designmaster0928/Calliope-Opens-Eyes/Photos/IMG_20220707_080942.jpg

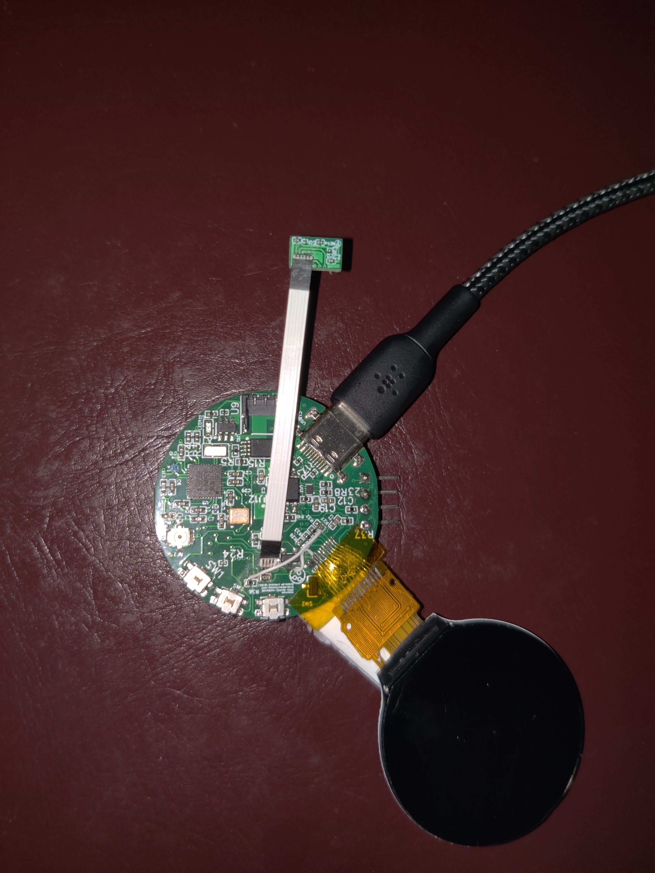
Photos/IMG_20220707_080942.jpg
