designmaster0928/Calliope-Opens-Eyes/Photos/IMG_20220710_211812.jpg

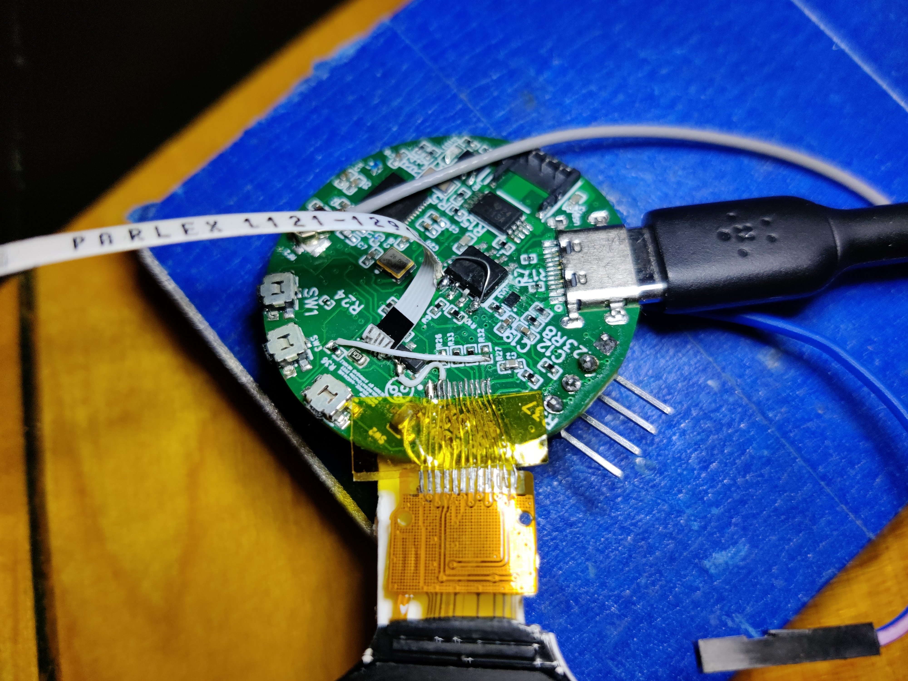
Photos/IMG_20220710_211812.jpg
