designmaster0928/Calliope-Opens-Eyes/Document/Belinda FPC adaptor 3f5895c3af74f1fa5b2311e33c003cb9.jpg

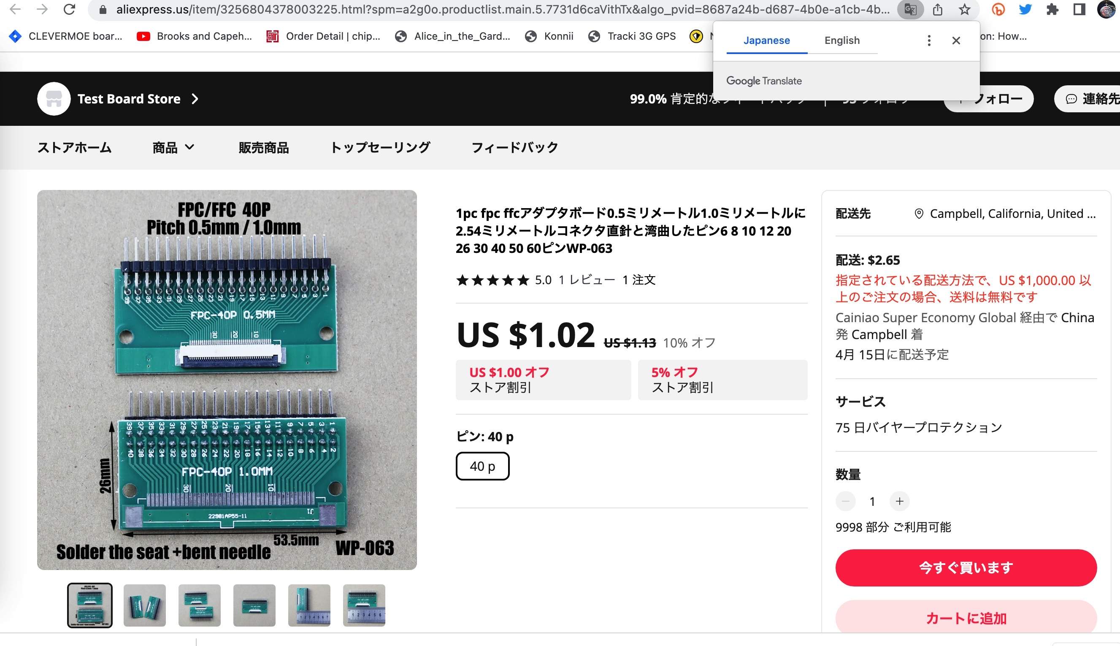
Document/Belinda FPC adaptor 3f5895c3af74f1fa5b2311e33c003cb9.jpg
