designmaster0928/Calliope-Opens-Eyes/Photos/CindyLou_daughter_board.jpg

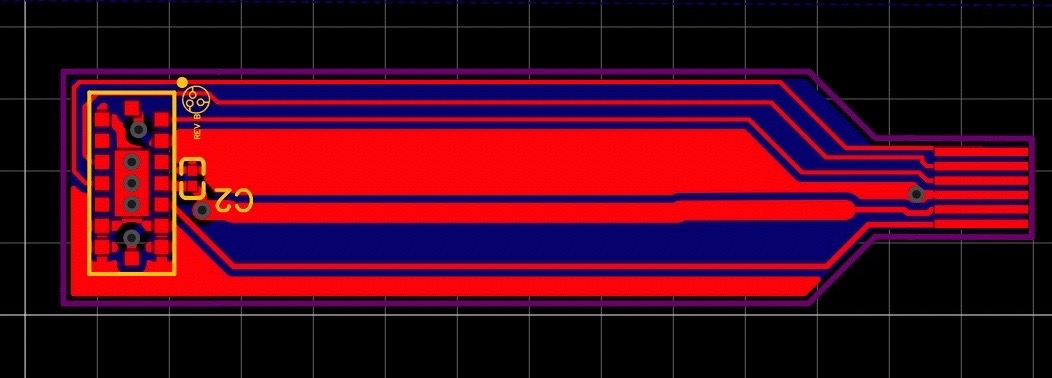
Photos/CindyLou_daughter_board.jpg
