designmaster0928/Calliope-Opens-Eyes/Photos/CindyLou_main_board.jpg

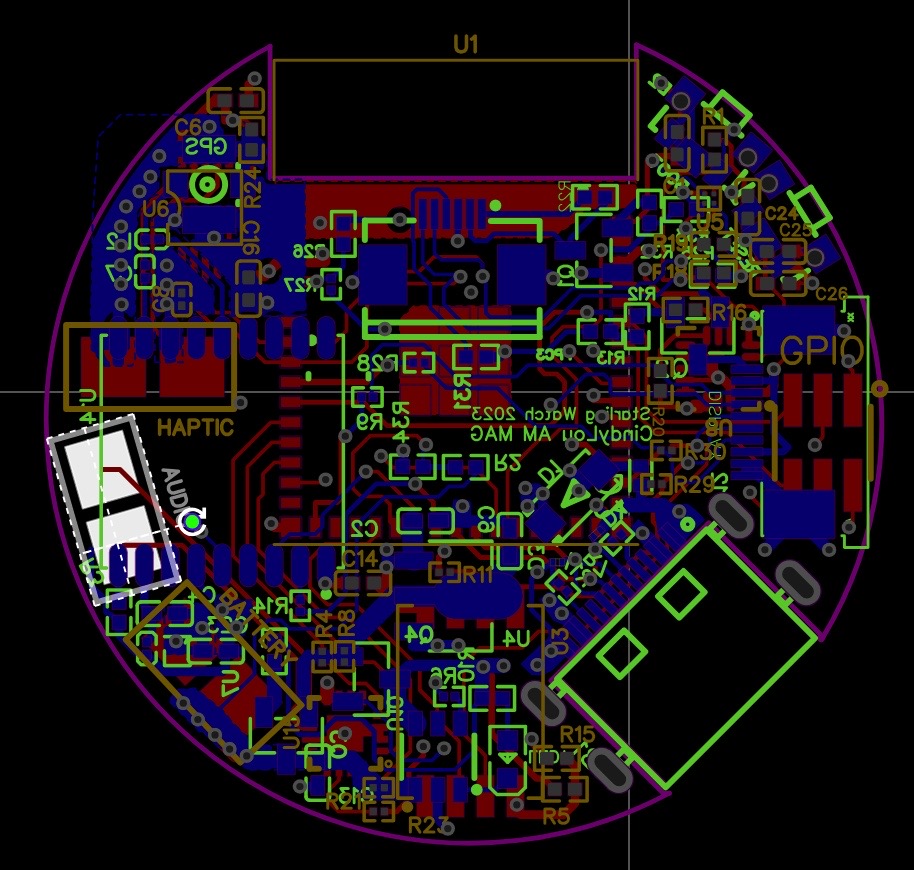
Photos/CindyLou_main_board.jpg
