designmaster0928/Calliope-Opens-Eyes/Photos/Hoober_with_reworks_back.jpg

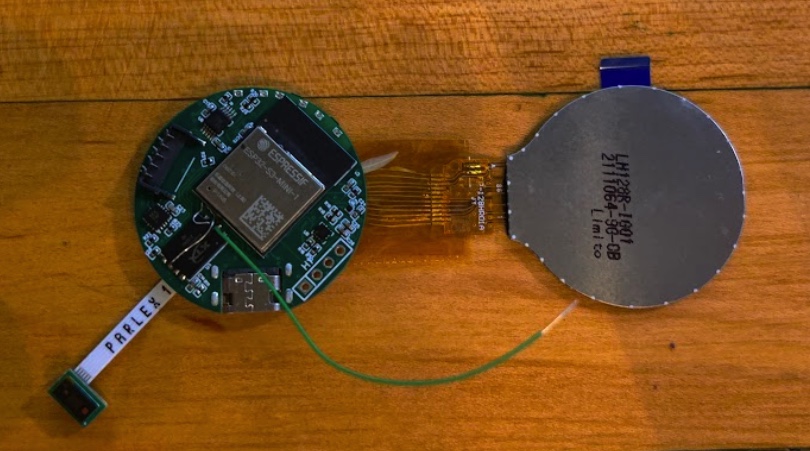
Photos/Hoober_with_reworks_back.jpg
