designmaster0928/Calliope-Opens-Eyes/Photos/Hoober_with_reworks_front.jpg

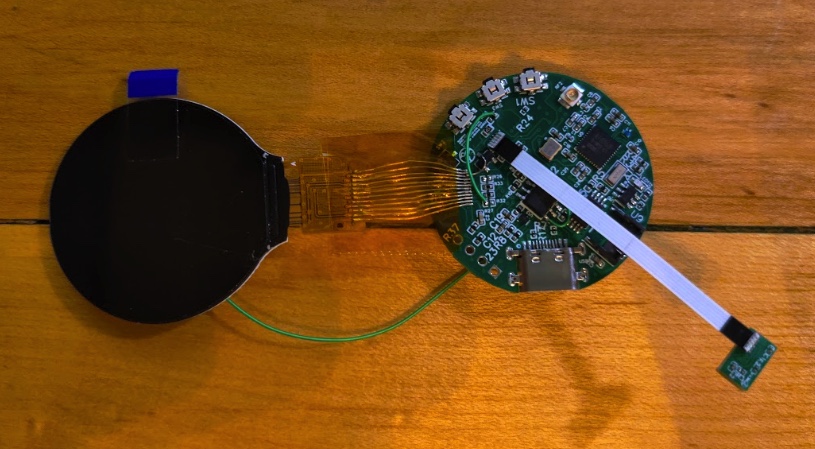
Photos/Hoober_with_reworks_front.jpg
