designmaster0928/Calliope-Opens-Eyes/Photos/IMG_20220601_134554.jpg

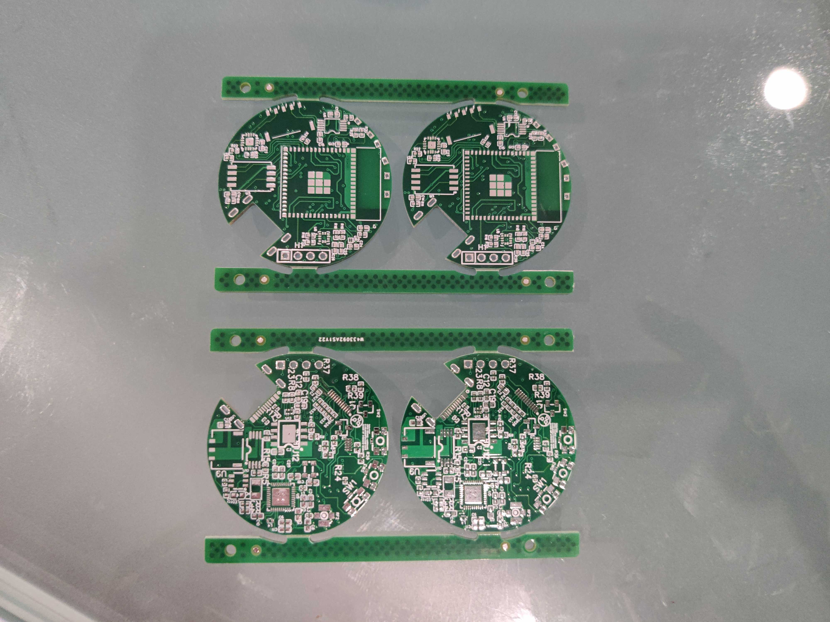
Photos/IMG_20220601_134554.jpg
