designmaster0928/Calliope-Opens-Eyes/Photos/IMG_20220627_172540.jpg

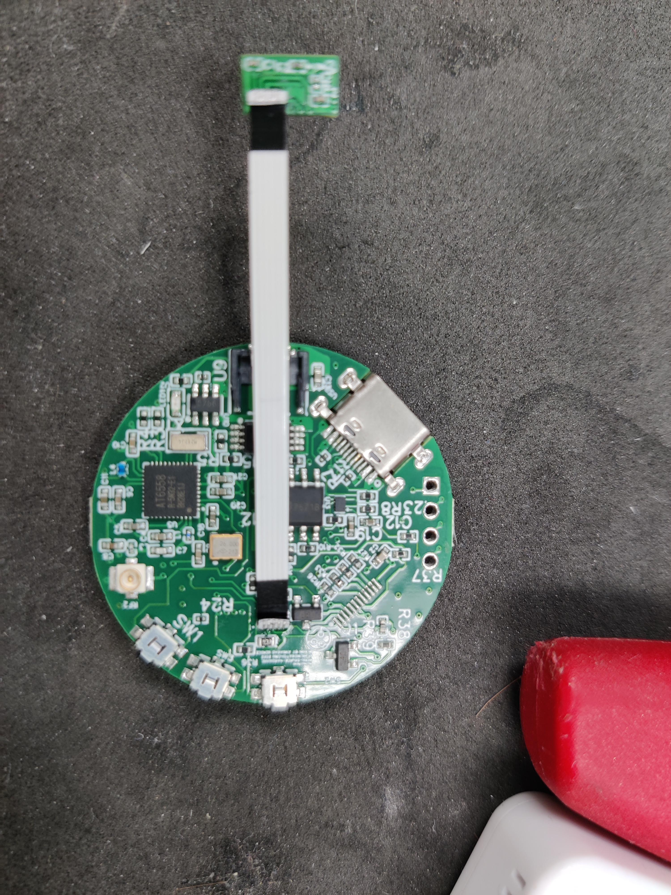
Photos/IMG_20220627_172540.jpg
