designmaster0928/Calliope-Opens-Eyes/Photos/IMG_20220627_172551.jpg

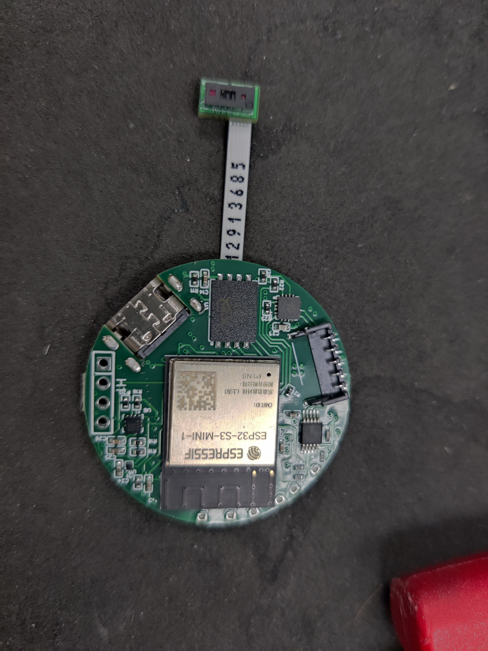
Photos/IMG_20220627_172551.jpg
