designmaster0928/Calliope-Opens-Eyes/Photos/IMG_20220627_183308.jpg

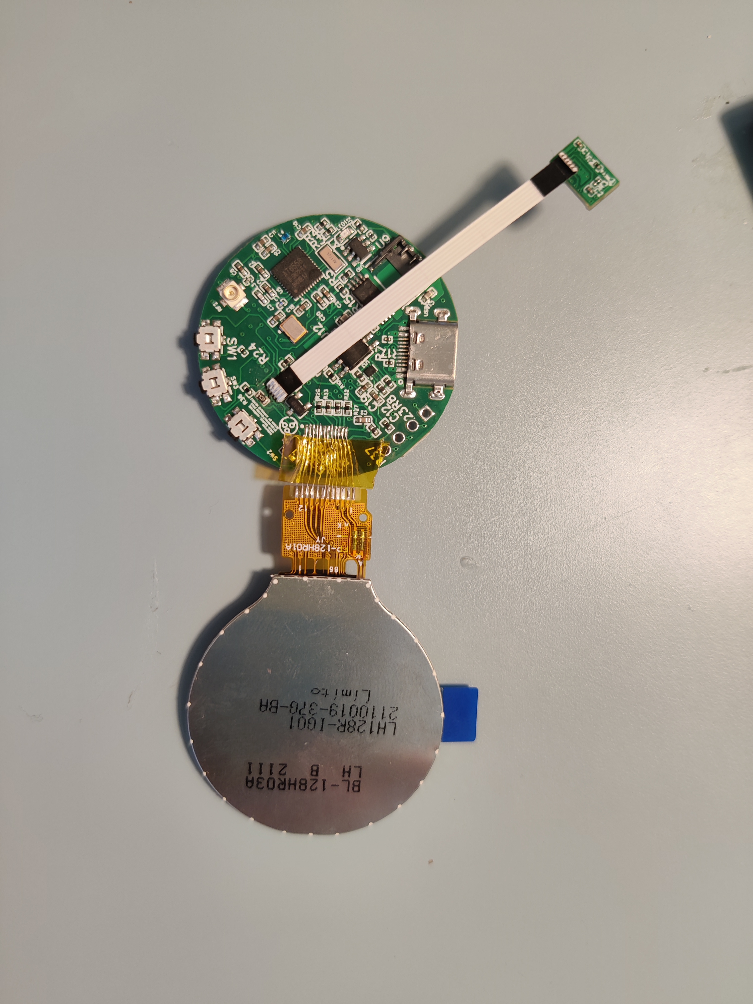
Photos/IMG_20220627_183308.jpg
