designmaster0928/Calliope-Opens-Eyes/Photos/IMG_20220627_183316.jpg

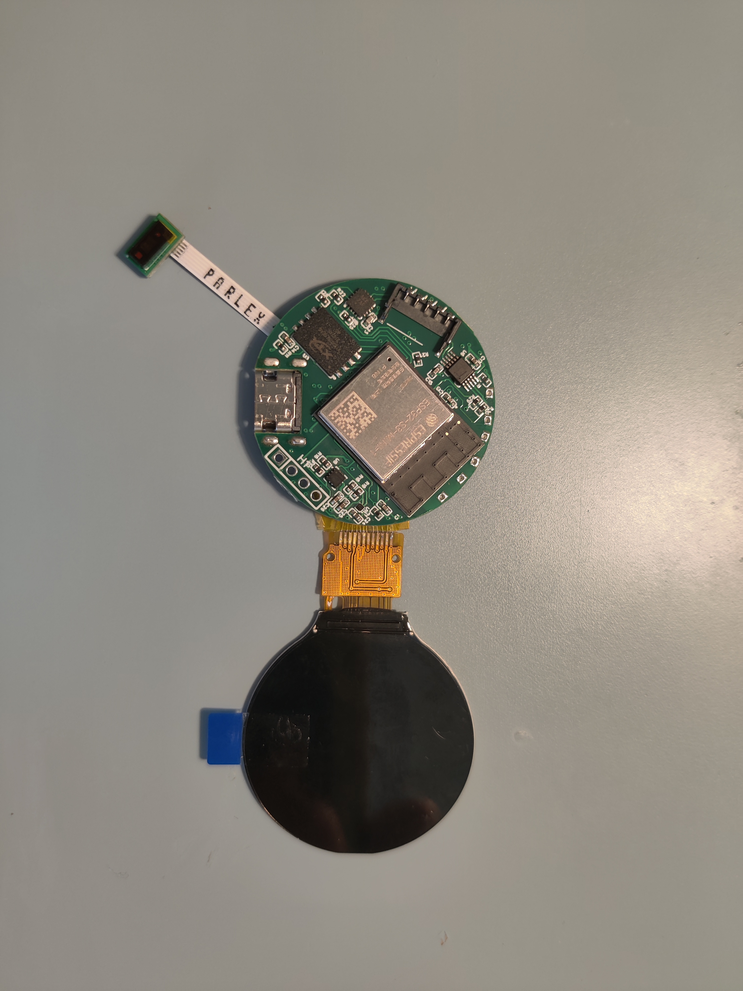
Photos/IMG_20220627_183316.jpg
