designmaster0928/Calliope-Opens-Eyes/Photos/screenshot_7177.jpg

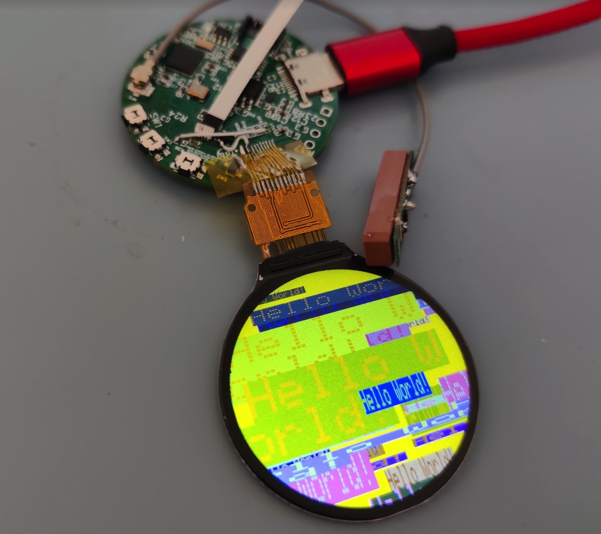
Photos/screenshot_7177.jpg
