designmaster0928/Calliope-Opens-Eyes/(list of files, drawings)

Other design files:
Device/CindyLou Main Board copy_2023-08-16.pcbdoc
Device/CindyLou Main Board copy_2023-08-16.schdoc
