designmaster0928/Calliope-Opens-Eyes/CalliopeOpensEyes/Video.cpp

/*
Reflections, distributed entertainment device

Repository is at https://github.com/frankcohen/ReflectionsOS
Includes board wiring directions, server side components, examples, support

Licensed under GPL v3 Open Source Software
(c) Frank Cohen, All rights reserved. fcohen@starlingwatch.com
Read the license in the license.txt file that comes with this code.

This file is for operating the video display.

*/

#include "Video.h"

Video::Video() {}

void Video::begin()
{
  _readyForNextVideo = true;
  _timer = millis() + 50;
  _needsSetupFlag = false;
  _needsPlayFlag = false;
  _firsttime = true;

  _total_frames = 0;
  _total_read_video = 0;
  _total_decode_video = 0;
  _total_show_video = 0;
  _start_ms = 0;
  _curr_ms = 0;

  // Configure TFT Display pins
  
  pinMode(Display_SPI_CS, OUTPUT);
  digitalWrite(Display_SPI_CS, HIGH);

  pinMode(Display_SPI_DC, OUTPUT);
  digitalWrite(Display_SPI_DC, HIGH);

  pinMode(Display_SPI_RST, OUTPUT);
  digitalWrite(Display_SPI_RST, HIGH);

  pinMode(Display_SPI_BK, OUTPUT);    // Backlight
  digitalWrite(Display_SPI_BK, LOW);
}

void Video::setNeedsSetup( boolean mns )
{
  _needsSetupFlag = mns;
}

boolean Video::needsSetup()
{
  return _needsSetupFlag;
}

void Video::clearNeedsSetup()
{
  _needsSetupFlag = false;
}

boolean Video::needsPlay()
{
  return _needsPlayFlag;
}

void Video::clearNeedsPlay()
{
  _needsPlayFlag = false;
}

boolean Video::getFirsttime()
{
  return _firsttime;
}

void Video::setFirsttime( boolean ft )
{
  _firsttime = ft;
}

File Video::getMjpegFile()
{
  return _mjpegFile;
}

void Video::setMjpegFile( File thefile )
{
  _mjpegFile = thefile;
}

boolean Video::getReadyForNextMedia()
{
  return _readyForNextVideo;
}

void Video::setReadyForNextMedia( boolean nm )
{
  _readyForNextVideo = nm;
}

unsigned long Video::addTotal_show_video( unsigned long msec )
{
  return _total_show_video += msec;
}

void Video::loop()
{
  if ( _readyForNextVideo ) return;

  if ( _mjpegFile.available() )
  {
    // Read video

    if ( millis() > _timer )
    {
      _timer = millis() + 50;
      _needsPlayFlag = true;
      _curr_ms = millis();
      _total_frames++;
    }
  }
  else
  {
    _mjpegFile.close();
    _readyForNextVideo = true;

    int _time_used = millis() - _start_ms;
    //float fps = 1000.0 * _total_frames / _time_used;
    //Serial.printf("FPS: %0.1f\n", fps);

    Serial.println(F("MJPEG end"));
    float fps = 1000.0 * _total_frames / _time_used;
    _total_decode_video -= _total_show_video;
    Serial.printf("Total frames: %d\n", _total_frames);
    Serial.printf("Time used: %d ms\n", _time_used);
    Serial.printf("Average FPS: %0.1f\n", fps);
    Serial.printf("Read MJPEG: %lu ms (%0.1f %%)\n", _total_read_video, 100.0 * _total_read_video / _time_used);
    Serial.printf("Decode video: %lu ms (%0.1f %%)\n", _total_decode_video, 100.0 * _total_decode_video / _time_used);
    Serial.printf("Show video: %lu ms (%0.1f %%)\n", _total_show_video, 100.0 * _total_show_video / _time_used);

    _total_frames = 0;
    _total_read_video = 0;
    _total_decode_video = 0;
    _total_show_video = 0;
    _start_ms = 0;
    _curr_ms = 0;    
  }

}
