designmaster0928/Calliope-Opens-Eyes/CalliopeOpensEyes/GPS.h

#ifndef _GPS_
#define _GPS_

#include "config.h"
#include "secrets.h"

#include <TinyGPSPlus.h>
#include <HardwareSerial.h>

#define GPSBaud 9600

class GPS
{
  public:
    GPS();
    void begin();
    void loop();
    bool test();

    void printHeader();
    void printLocation();
    void printFloat(float val, bool valid, int len, int prec);
    void printInt(unsigned long val, bool valid, int len);
    void printDateTime(TinyGPSDate &d, TinyGPSTime &t);
    void printStr(const char *str, int len);

  private:
    TinyGPSPlus gps;
};

#endif // _GPS_
