designmaster0928/Calliope-Opens-Eyes/CalliopeOpensEyes/AudioSampleAAC.h

const unsigned char sampleaac[] PROGMEM = {
  0xff, 0xf1, 0x50, 0x80, 0x1c, 0x3f, 0xfc, 0xda, 0x00, 0x4c, 0x61, 0x76 };

/*
const unsigned char sampleaac[] PROGMEM = {
  0xff, 0xf1, 0x50, 0x80, 0x1c, 0x3f, 0xfc, 0xda, 0x00, 0x4c, 0x61, 0x76,
  0x63, 0x35, 0x32, 0x2e, 0x37, 0x30, 0x2e, 0x30, 0x00, 0x42, 0x78, 0xa9,
  0xb6, 0x89, 0x29, 0x84, 0x41, 0x42, 0x83, 0x9a, 0xac, 0xd6, 0xff, 0x5f,
  0x9f, 0x8f, 0x3e, 0xab, 0x3d, 0x6b, 0x7d, 0x63, 0x61, 0xc2, 0xfc, 0xfe,
  0x0a, 0xa0, 0x79, 0x76, 0x2a, 0x66, 0xab, 0x74, 0xf6, 0x3e, 0x54, 0xf5,
  0x2d, 0xde, 0xac, 0x3e, 0x3f, 0xb5, 0xf5, 0xf5, 0x2d, 0xd4, 0x2d, 0xcd,
  0x29, 0x5d, 0x0a, 0xa3, 0x08, 0xaa, 0xa2, 0x16, 0x55, 0x0a, 0xb7, 0x5f,
  0xd7, 0xd5, 0x8c, 0x6a, 0xdb, 0xd5, 0xdd, 0x86, 0xc8, 0xbc, 0x0b, 0xb2,
  0xfe, 0xad, 0x91, 0x69, 0xf0, 0x3c, 0x52, 0x26, 0x4f, 0x99, 0x96, 0x3b,
  0x0d, 0xd9, 0x87, 0x66, 0xd3, 0xfd, 0xae, 0x2d, 0xb9, 0x91, 0xe7, 0x56,
  0x4a, 0x23, 0x0a, 0x41, 0x1b, 0x7b, 0xf6, 0xdb, 0x65, 0xa1, 0xde, 0x79,
  0x2e, 0x4b, 0x97, 0xef, 0xf7, 0xfb, 0xfd, 0xfe, 0xff, 0x7f, 0xbf, 0xd8,
  0x18, 0x18, 0x18, 0x18, 0x18, 0x18, 0x18, 0x18, 0x18, 0x18, 0x18, 0x18,
  0x18, 0x18, 0x18, 0x18, 0x18, 0x18, 0x18, 0x18, 0x18, 0x18, 0x18, 0x18,
  0x18, 0x18, 0x18, 0x18, 0x18, 0x18, 0x18, 0x18, 0x18, 0x18, 0x18, 0x18,
  0x18, 0x18, 0x18, 0x1c, 0xda, 0xa8, 0xf2, 0x0e, 0x6a, 0xb3, 0x5b, 0xfd,
  0x7e, 0x7e, 0x3c, 0xfa, 0xac, 0xf5, 0xad, 0xf5, 0x8d, 0x87, 0x0b, 0xf3,
  0xf8, 0x2a, 0x80, 0x00, 0x00, 0x00, 0x00, 0x00, 0x00, 0x00, 0x00, 0x00,
  0x00, 0x00, 0x00, 0x00, 0x00, 0x00, 0x00, 0x00, 0x70, 0xff, 0xf1, 0x50,
  0x80, 0x23, 0x5f, 0xfc, 0x21, 0x57, 0x6d, 0x46, 0x5f, 0x0c, 0xa1, 0x51,
  0x82, 0xc6, 0x25, 0x28, 0x37, 0xa0, 0xb5, 0x72, 0x47, 0xf5, 0xe2, 0xe4,
  0x4f, 0x9e, 0x2e, 0x44, 0xcd, 0x5c, 0x90, 0x36, 0x03, 0x71, 0x74, 0x73,
  0x64, 0x61, 0x7a, 0x2b, 0x3e, 0x58, 0xa6, 0xce, 0x5f, 0x4d, 0xe2, 0xd8,
  0xeb, 0x0e, 0xe0, 0x72, 0x5c, 0x25, 0xcb, 0xed, 0x0f, 0x24, 0xbd, 0xee,
  0x75, 0x8d, 0xcf, 0xc9, 0xe9, 0x13, 0x14, 0x8e, 0xb9, 0x6d, 0xd9, 0xe2,
  0x17, 0x73, 0xa3, 0xbc, 0x77, 0x9a, 0x7f, 0x36, 0x5f, 0x59, 0x3b, 0x34,
  0xa9, 0x13, 0x12, 0x91, 0xd9, 0x65, 0xd6, 0xc6, 0xdb, 0xe1, 0x23, 0x53,
  0xe5, 0xef, 0x2f, 0x5f, 0xdf, 0x32, 0xb6, 0x8b, 0x7a, 0x8c, 0x46, 0x74,
  0x36, 0x12, 0x62, 0xda, 0x90, 0x55, 0x3f, 0xfb, 0x4a, 0x57, 0x62, 0x4c,
  0xca, 0x8d, 0xfa, 0x9f, 0xdb, 0xb1, 0x47, 0x6b, 0x4a, 0x47, 0xe1, 0x68,
  0x2c, 0x2b, 0x0f, 0xe1, 0x25, 0x62, 0xe3, 0xd9, 0x26, 0xbd, 0xa4, 0x82,
  0x5a, 0x6e, 0x5b, 0x40, 0x3f, 0x7a, 0x3a, 0x65, 0x50, 0x03, 0xd4, 0x38,
  0xd1, 0xba, 0xa7, 0x39, 0xae, 0xeb, 0x4f, 0xc8, 0xfd, 0x37, 0x44, 0xe5,
  0x2b, 0xdf, 0x75, 0x5d, 0xd7, 0x1e, 0x9c, 0x64, 0xcb, 0x6f, 0x24, 0xba,
  0x79, 0x49, 0xcd, 0xd9, 0x4d, 0x5c, 0x91, 0xfd, 0x78, 0xb9, 0x13, 0xe7,
  0x8b, 0x91, 0x33, 0x57, 0x24, 0x00, 0x00, 0x00, 0x00, 0x00, 0x00, 0x00,
  0x03, 0x1e, 0x90, 0xd5, 0xf9, 0x41, 0xa7, 0xe2, 0x87, 0xd8, 0xb8, 0x60,
  0x1f, 0x65, 0xf1, 0xfb, 0x5e, 0x10, 0x07, 0x6f, 0xe3, 0x72, 0x2c, 0xe6,
  0xea, 0x78, 0x1c, 0x93, 0x8b, 0xc1, 0xf4, 0x3a, 0x07, 0xf7, 0xf5, 0x5c,
  0x6f, 0xb1, 0x3c, 0x0f, 0x2f, 0x83, 0xff, 0x58, 0xa2, 0xd6, 0x94, 0x8f,
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
};
*/
